el-bodo-es-loco/Rave_Control_V2/20250503_093003.jpg

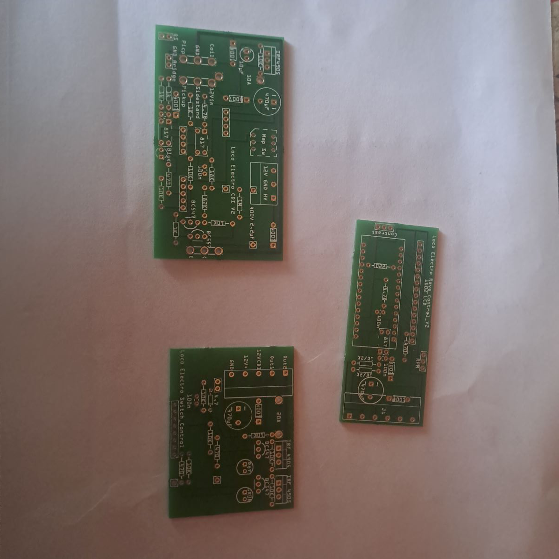
20250503_093003.jpg
