el-bodo-es-loco/Rave_Control_V2/20250503_093209.jpg

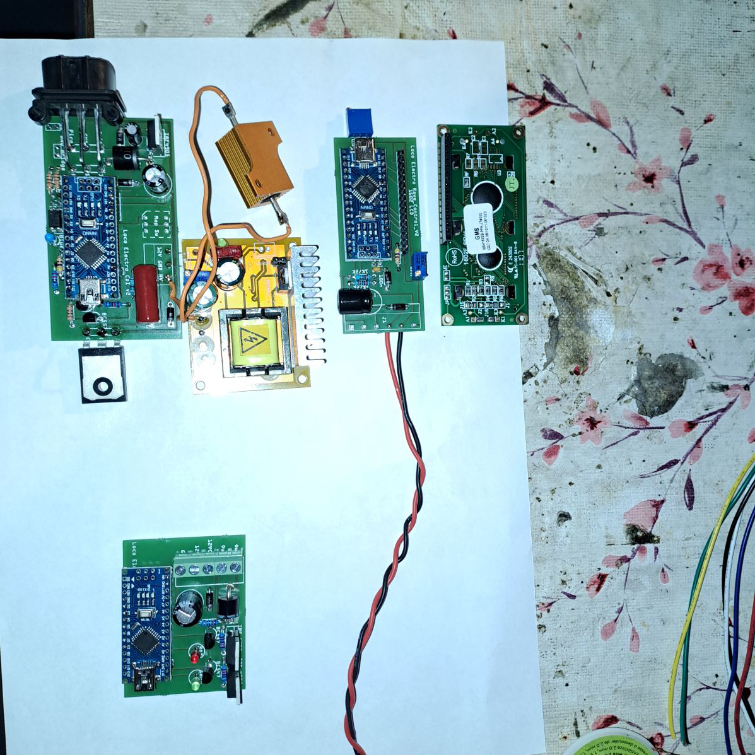
20250503_093209.jpg
