el-bodo-es-loco/Rave_Control_V2/RAVE Control V2_Schaltplan.jpg

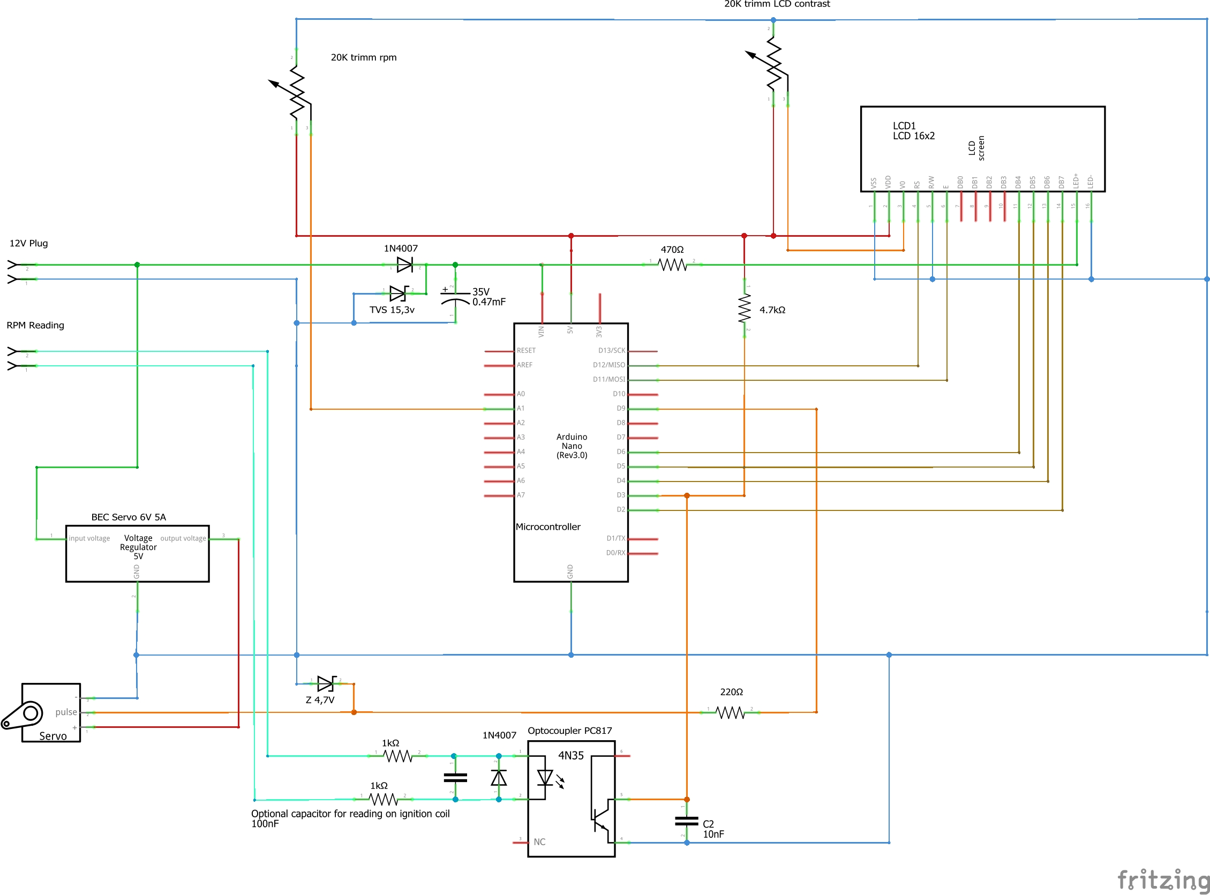
RAVE Control V2_Schaltplan.jpg
