el-bodo-es-loco/Rave_Control_V2/Partlist_Teileliste_Rave_Control_V2.xls

Bauteil |  | Wert | Anzahl | Artikelnummer Reichelt
Kondensator |  | 470µF | 1 | FR-A 470U 25A
Kondensator |  | 100nF | 1 | C3X7R 100NA50
Kondensator |  | 10nF | 1 | C3X7R 10N 100
Stiftleiste | (Optional) | 6 Polig | 1 | CTB0502-6
Widerstand |  | 4,7KΩ | 1 | METALL 4,70K
Widerstand |  | 1KΩ | 2 | METALL 1,00K
Widerstand |  | 470Ω | 1 | METALL 470
Widerstand |  | 220Ω | 1 | METALL 220
Trimm Poti |  | 20KΩ | 2 | 64W-20K
Diode |  | Zenerdiode, 4,7 V | 1 | BZX 55C4V7 VIS
Diode |  | 1N4007 | 2 | 1N 4007 DIO
Diode |  | TVS 15,3V 1,5KW | 1 | 1,5KE18CA
Diode |  | TVS 6,8V 1,5KW | 1 | 1,5KE6,8CA TSC
Optokoppler |  | PC817 | 1 | PC817X1NSZ1B
LCD Display |  | LCD 16x2 | 1 | DEBO LCD 16X2 BL
IC |  | Arduino Nano 328P | 1 | ARD NANO V3P
Platine bei Aisler unter: |  | https://aisler.net/p/TJOGOPLV
Einkaufsliste Reichelt: |  | https://www.reichelt.de/my/2277899
