el-bodo-es-loco/Rave_Control_V2/RAVE Control V2_Schaltplan.pdf

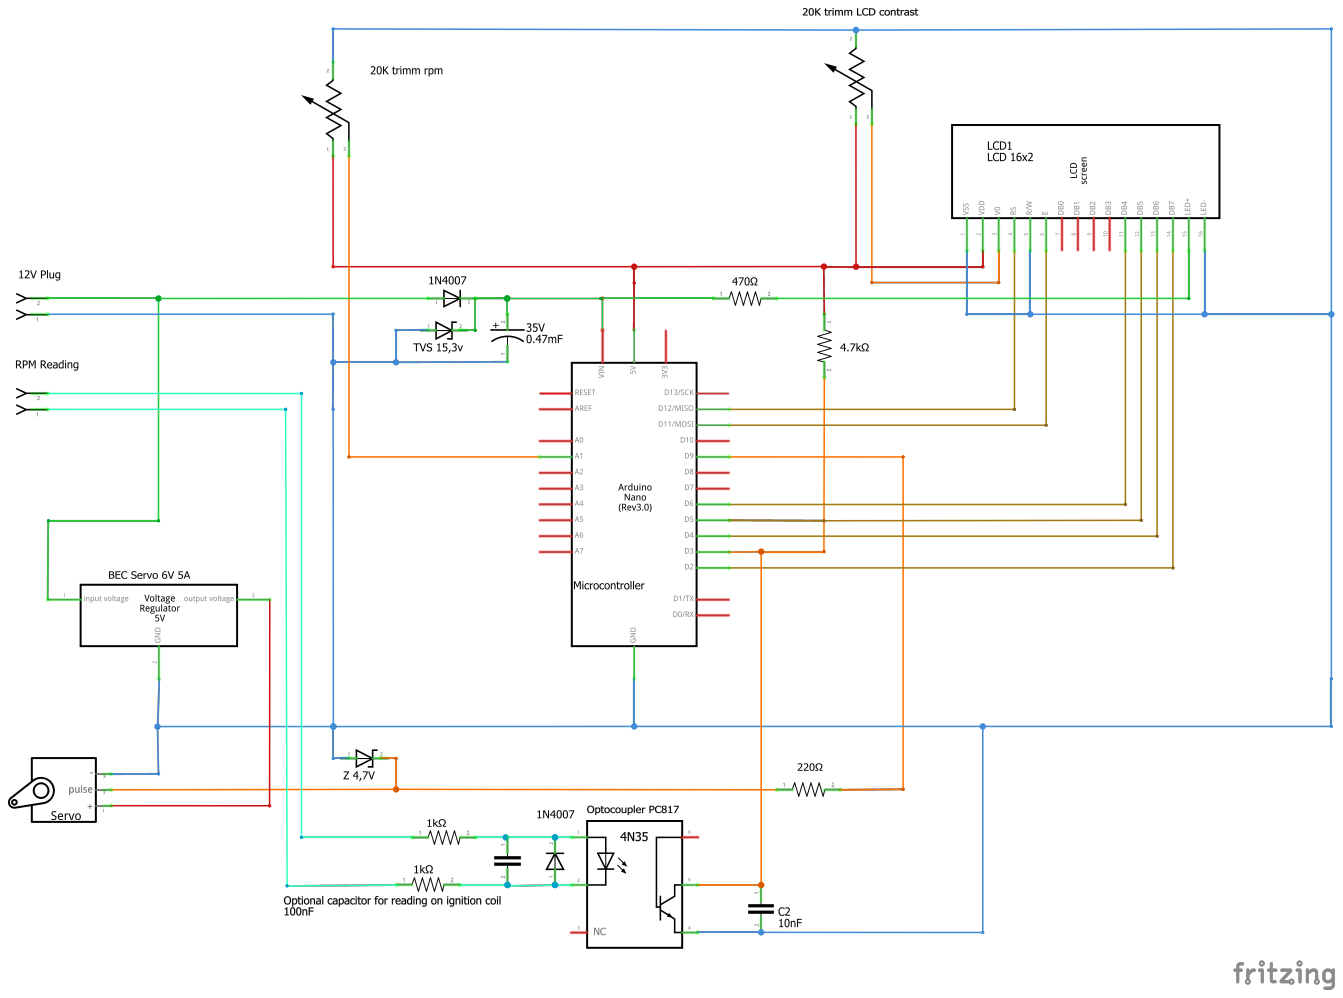
[picture p5: page 1]
