el-bodo-es-loco/Rave_Control_V2/(list of files, drawings)

Other design files:
Rave Control V2_PCB.fzz
